temurtas/EE313-Project/README.md

# EE313-Project
Frequency Modulated Continuous Wave (FMCW) Based Distance Measuring System

Our EE313/Analog Electronics Laboratory Course Term Project about FMCW Radar Systems

------------
Halil Temurtaş
Erdem Tuna

METU / Ankara / Turkey
