temurtas/EE313-Project/Adsız.png

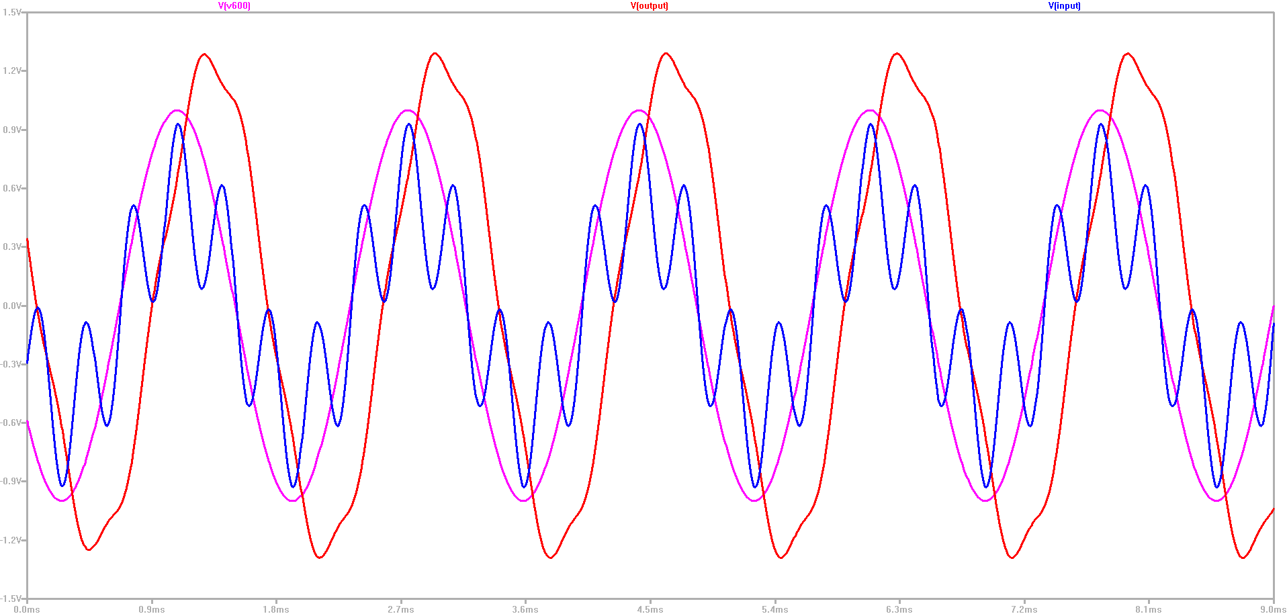
Adsız.png
