temurtas/EE313-Project/agc.png

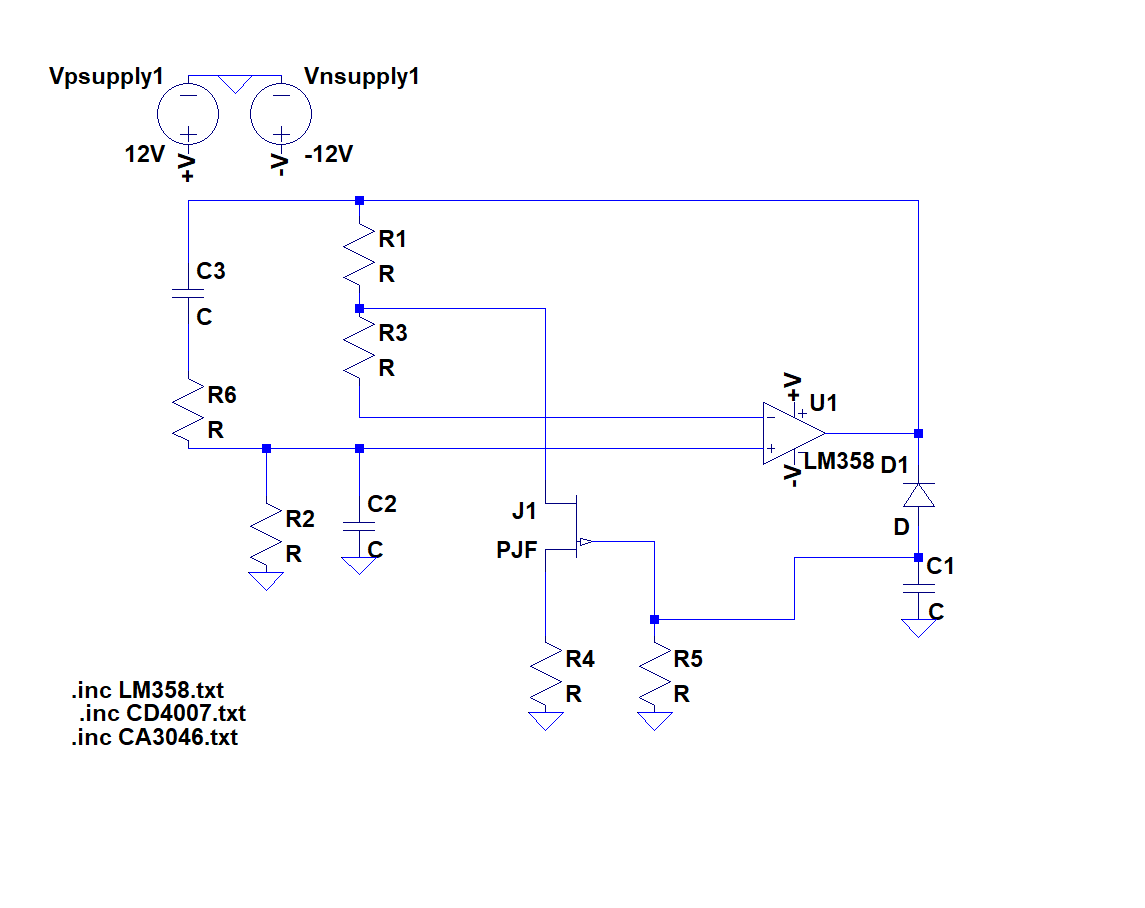
agc.png
