temurtas/EE313-Project/diagram2.png

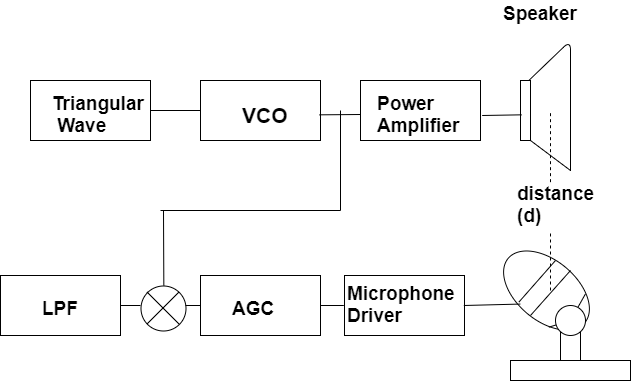
diagram2.png
