temurtas/EE313-Project/diagram3.png

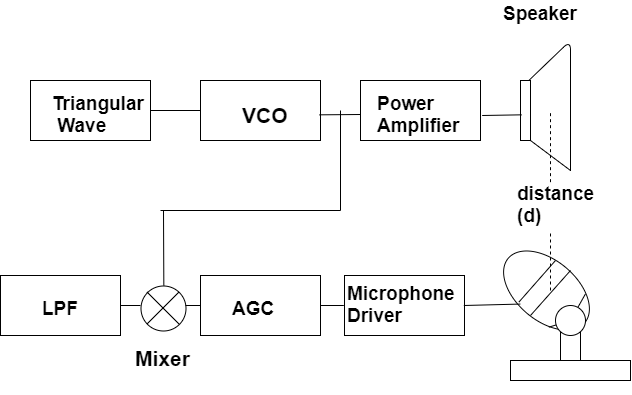
diagram3.png
