temurtas/EE313-Project/diagram.png

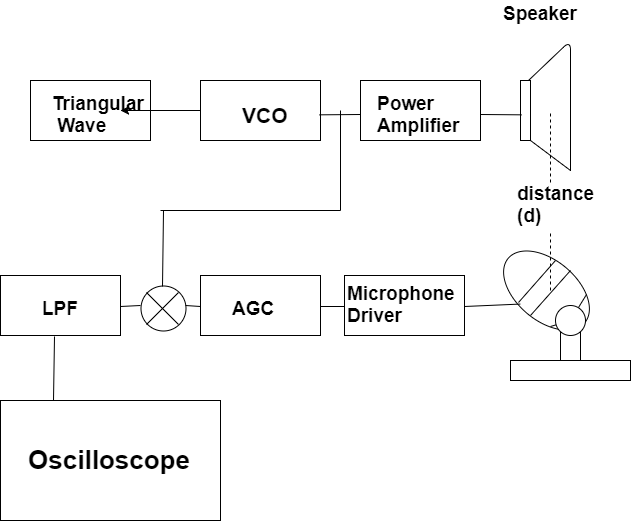
diagram.png
