temurtas/EE313-Project/electret.png

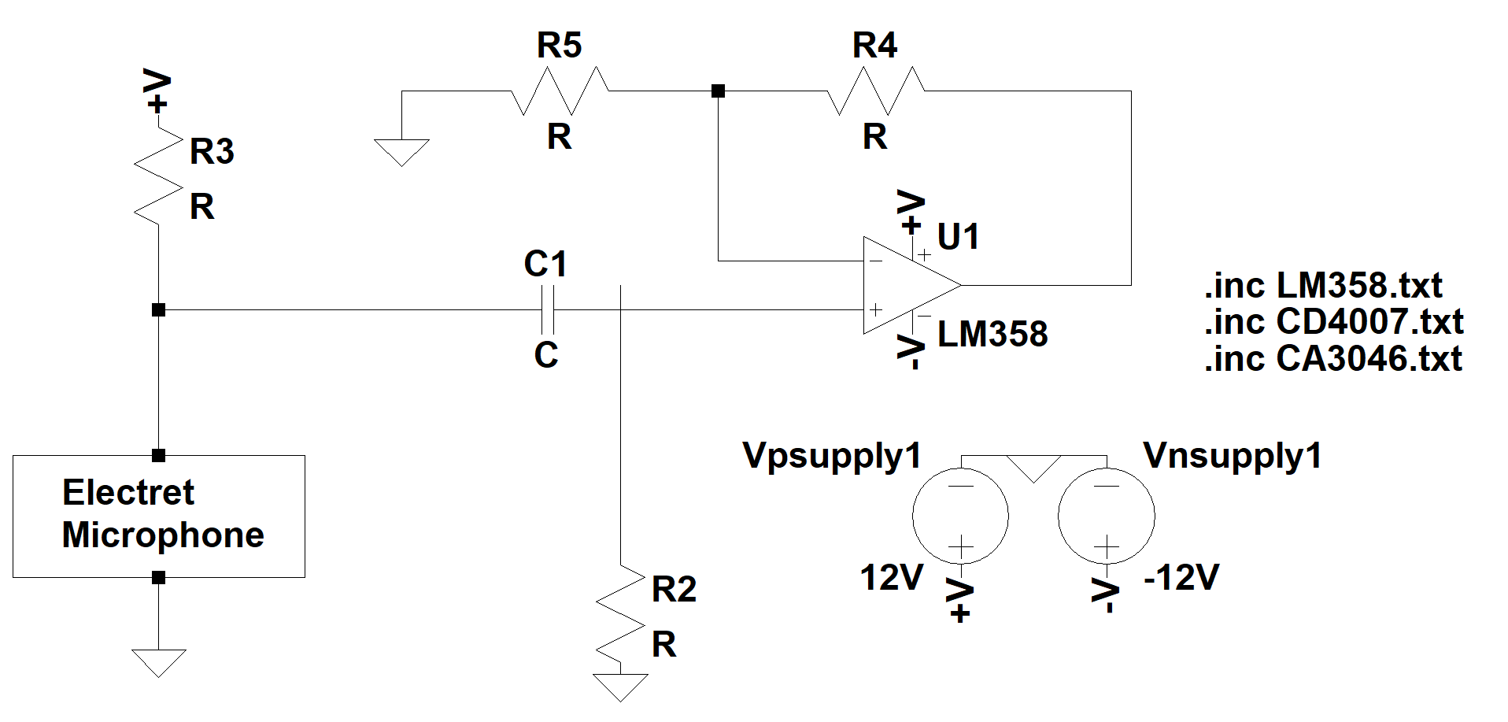
electret.png
