temurtas/EE313-Project/lpf_op1.png

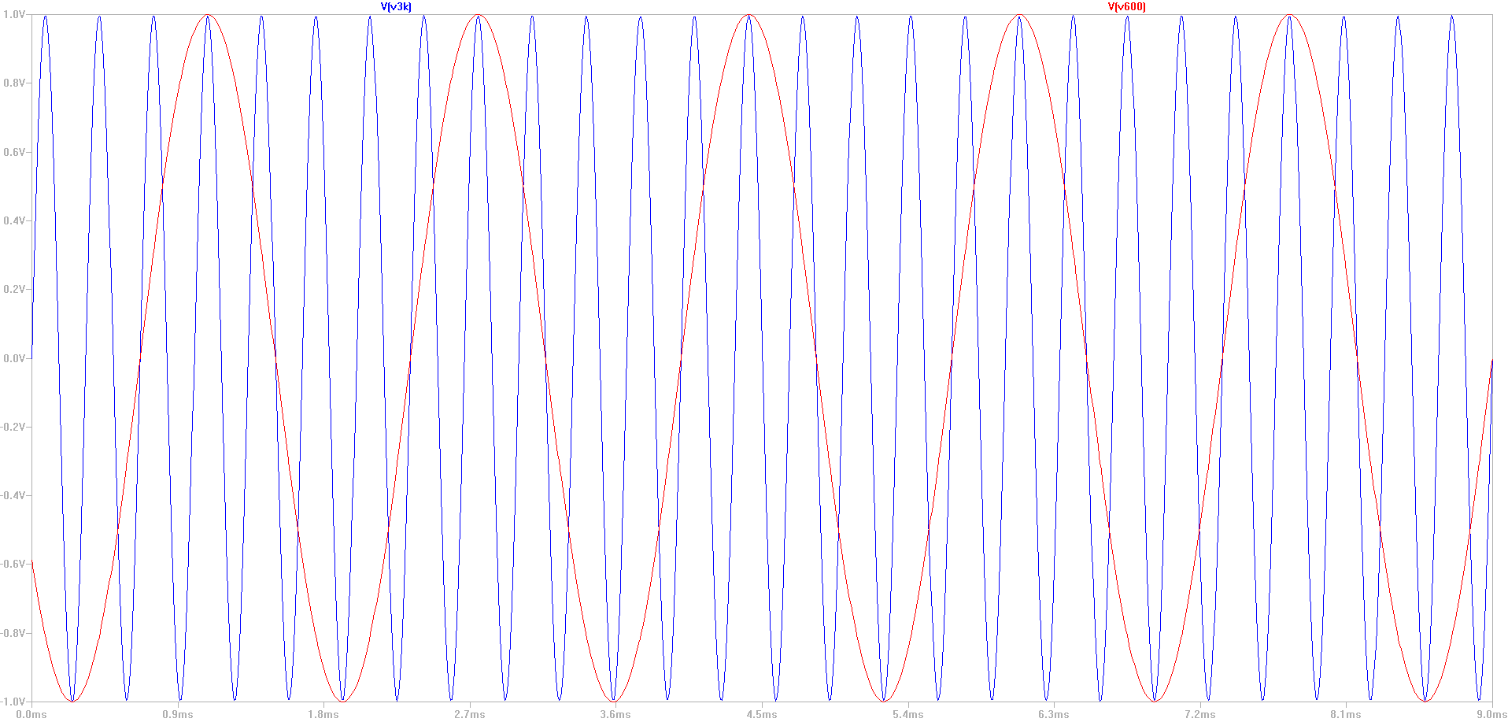
lpf_op1.png
