temurtas/EE313-Project/lpf_op2.png

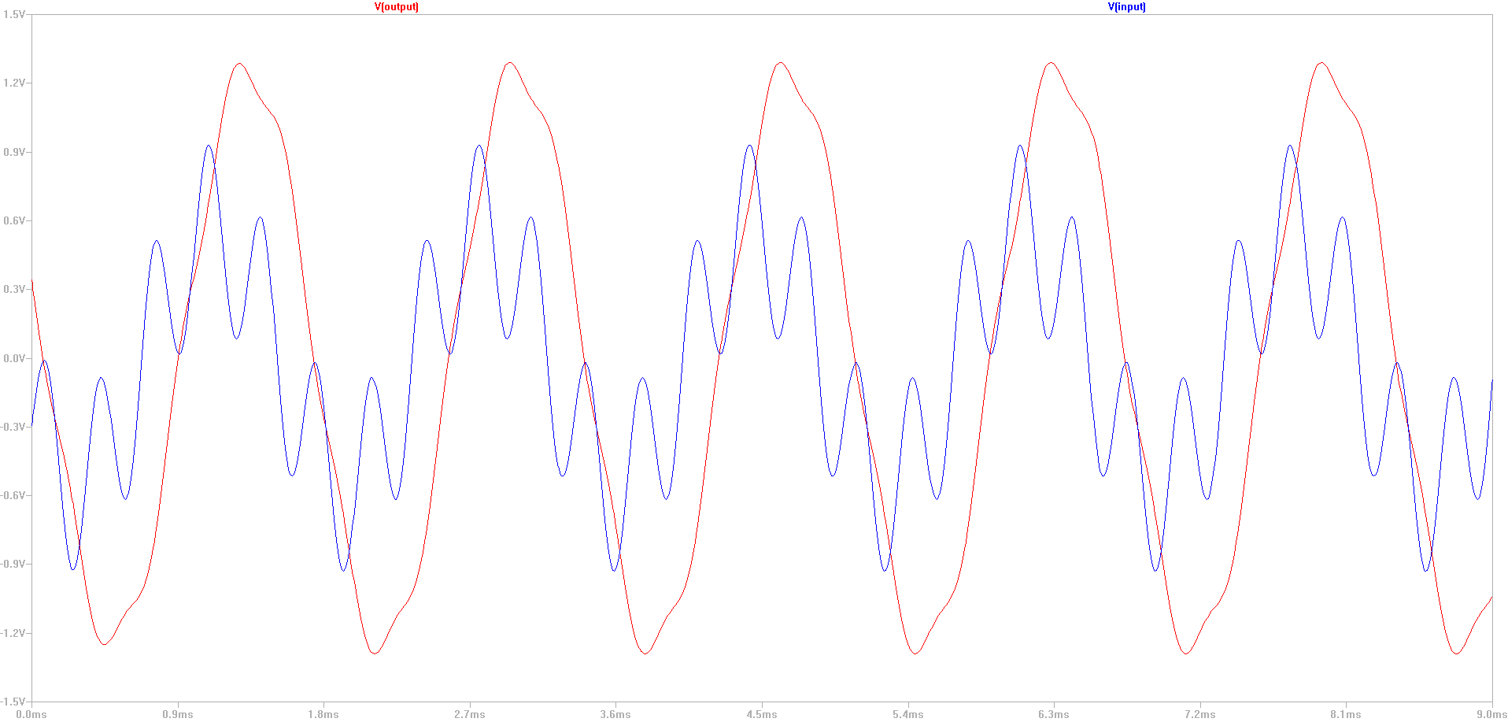
lpf_op2.png
