temurtas/EE313-Project/lpf_osc1.png

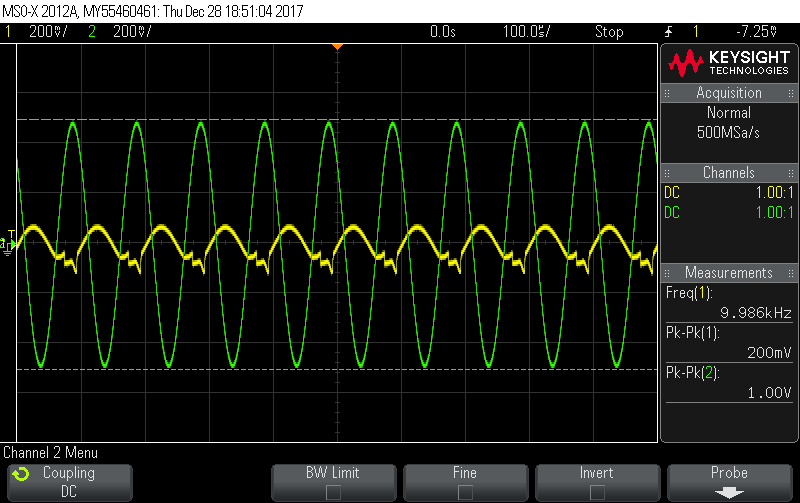
lpf_osc1.png
