temurtas/EE313-Project/lpf_osc3.png

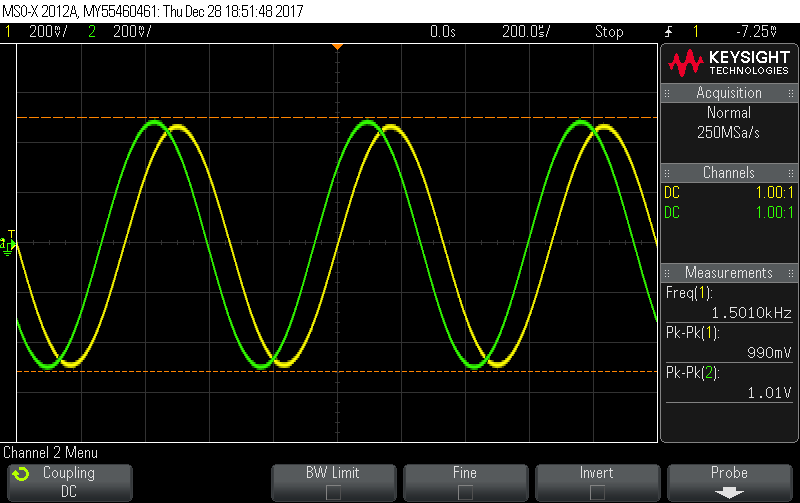
lpf_osc3.png
