temurtas/EE313-Project/lpf_v1.5.png

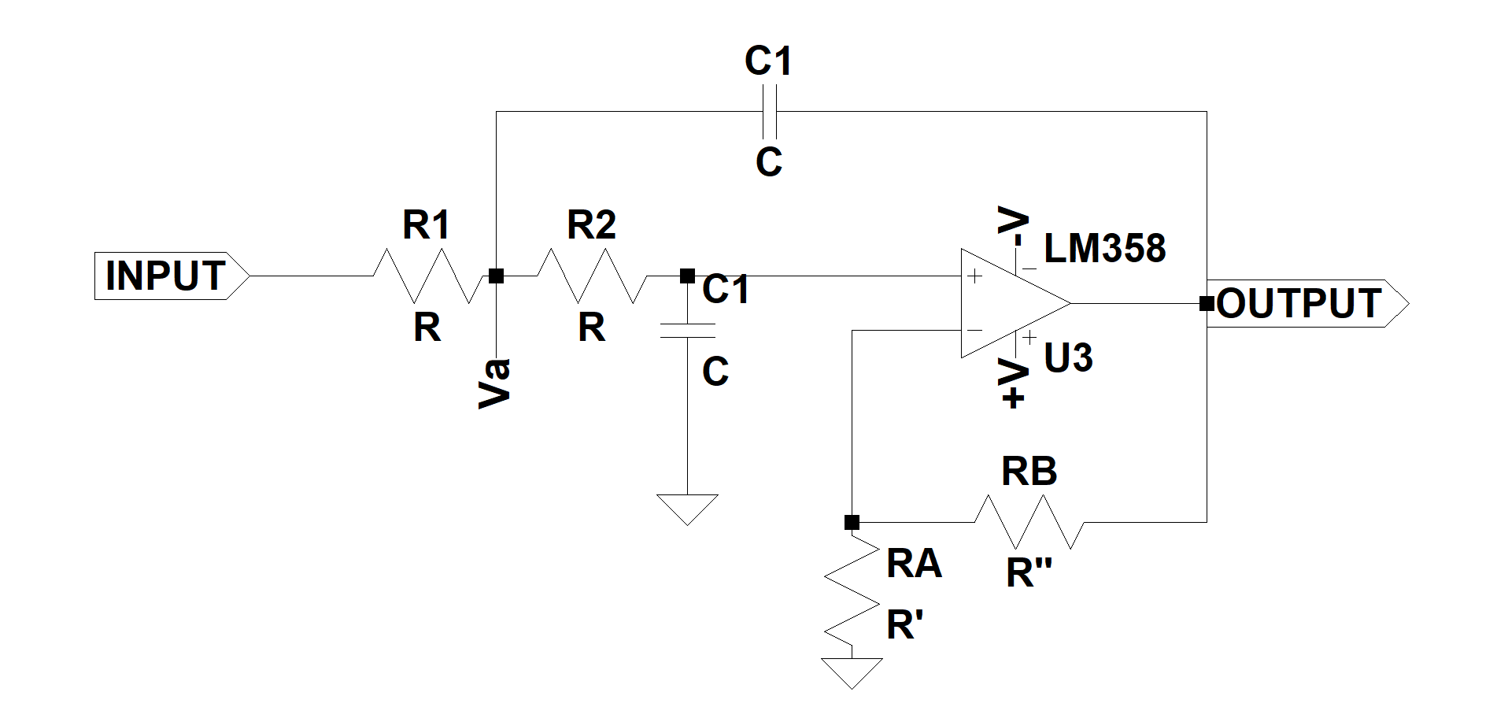
lpf_v1.5.png
