temurtas/EE313-Project/lpf_v1.png

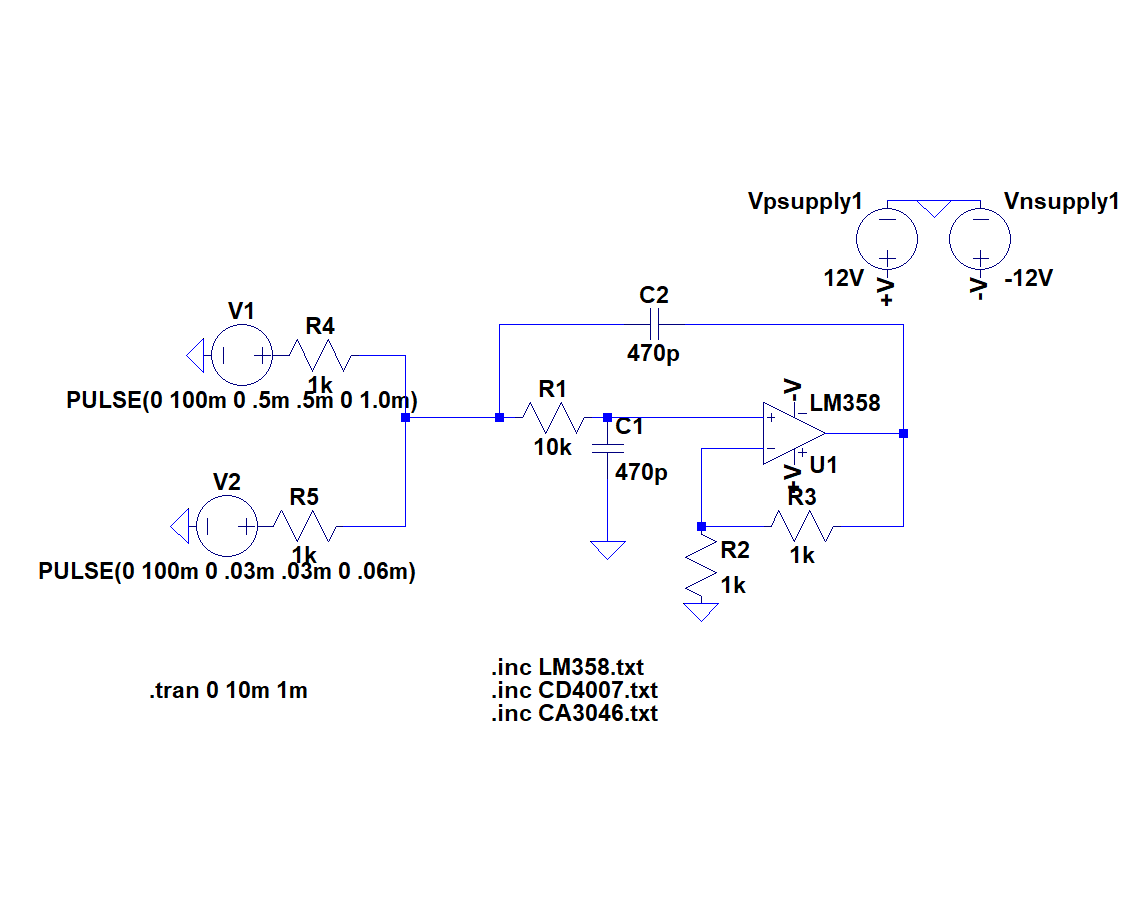
lpf_v1.png
