temurtas/EE313-Project/lpf_v3.png

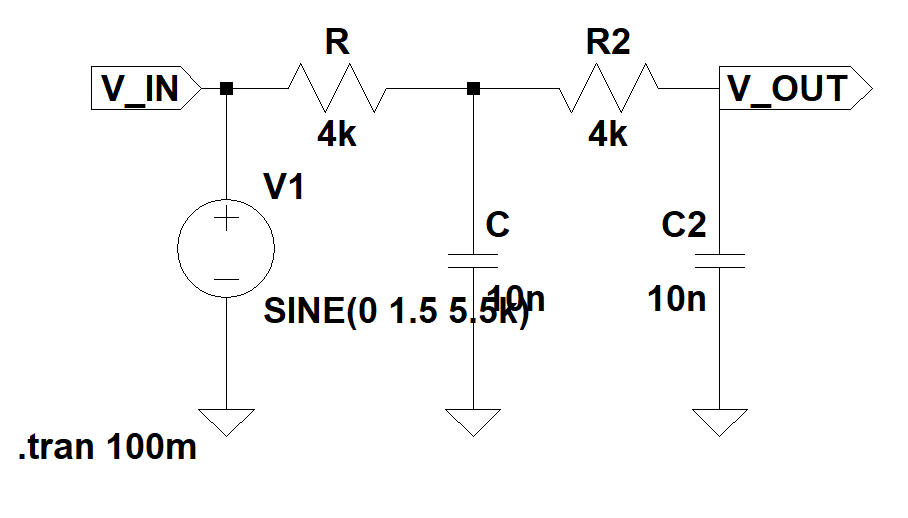
lpf_v3.png
