temurtas/EE313-Project/mic_v1.png

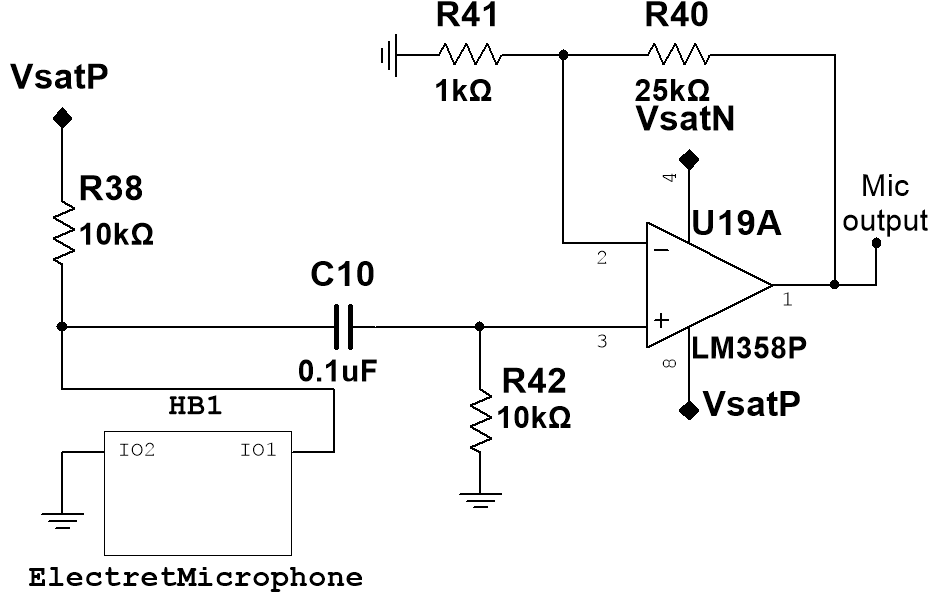
mic_v1.png
