temurtas/EE313-Project/mixer_fft2.png

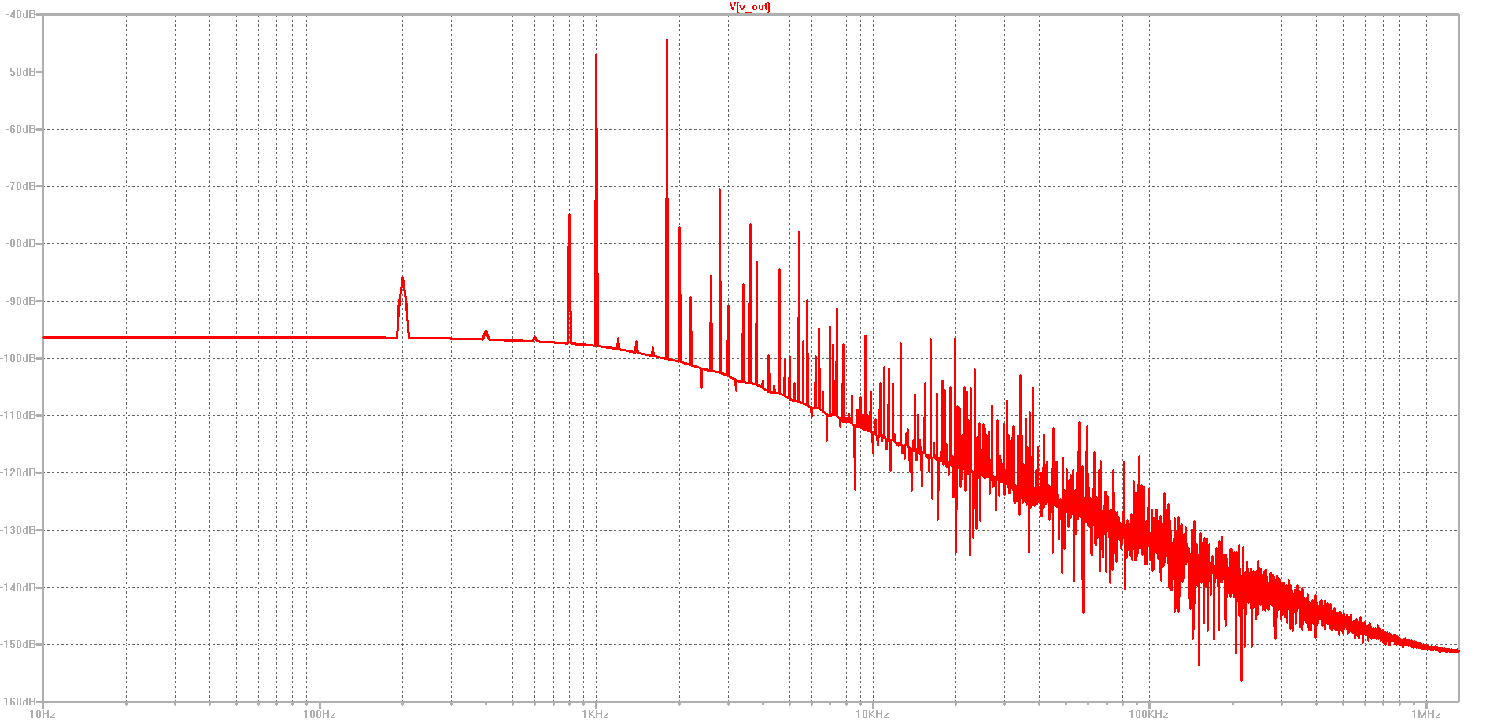
mixer_fft2.png
