temurtas/EE313-Project/mixer_fft.png

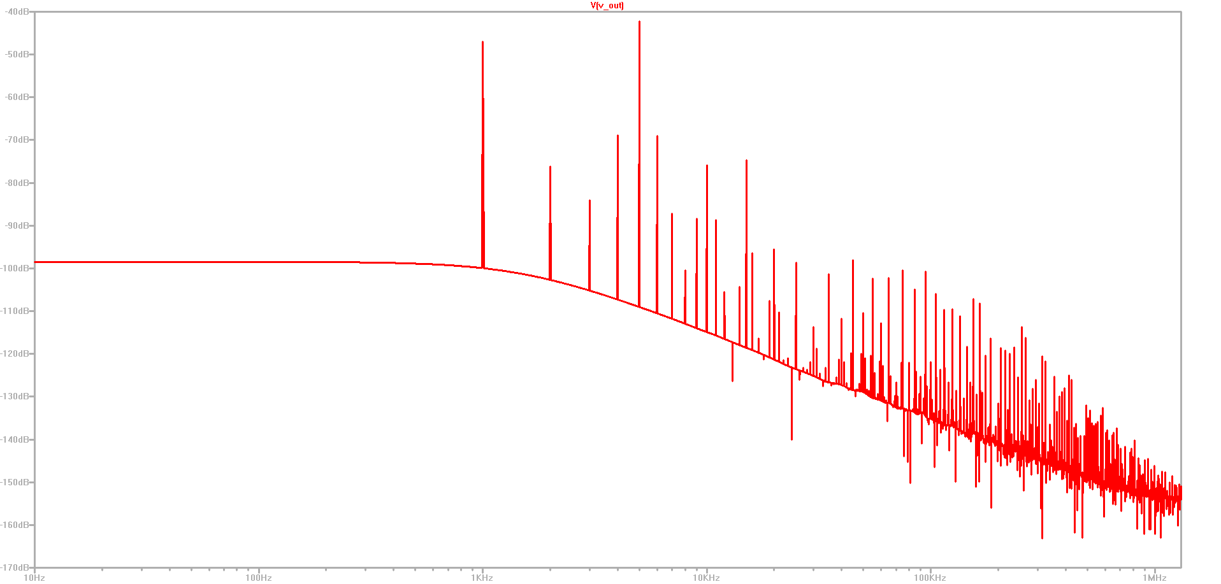
mixer_fft.png
