temurtas/EE313-Project/mixer_op1.png

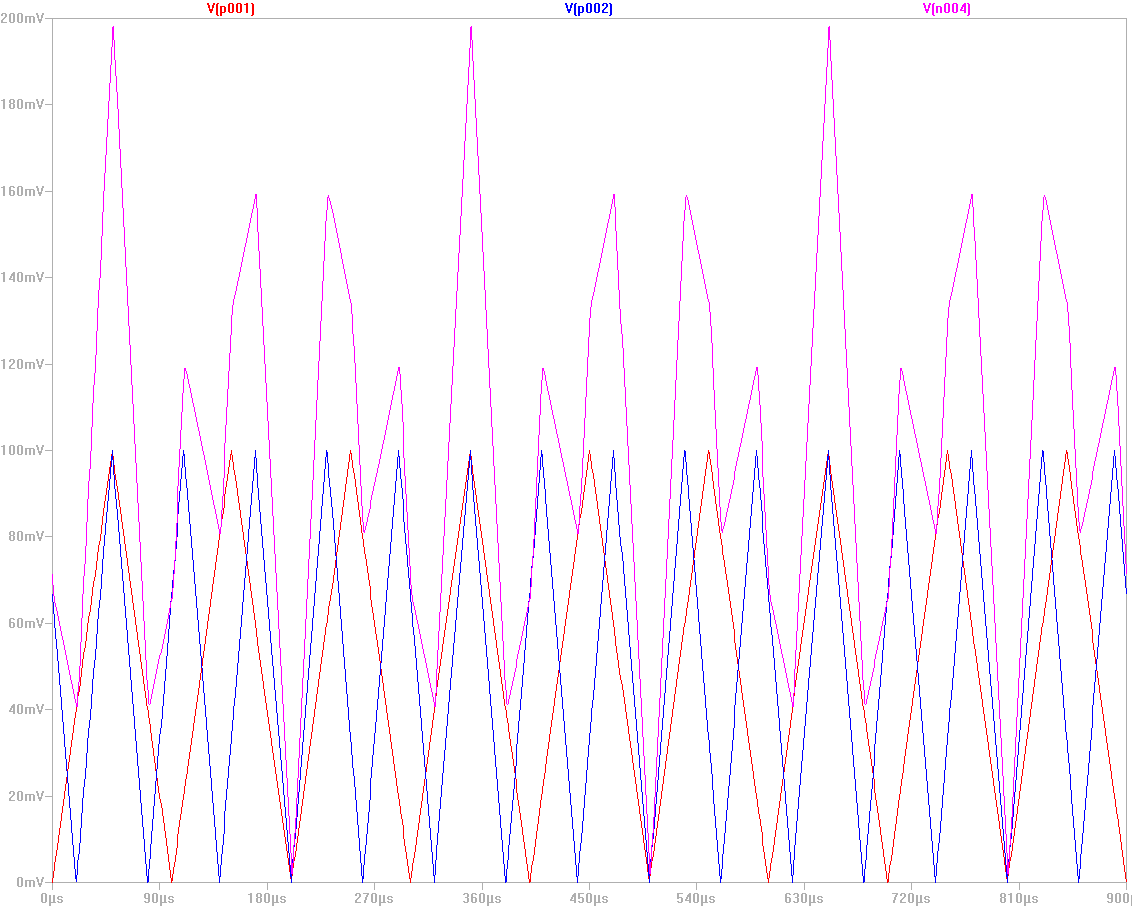
mixer_op1.png
