temurtas/EE313-Project/mixer_op1_5.png

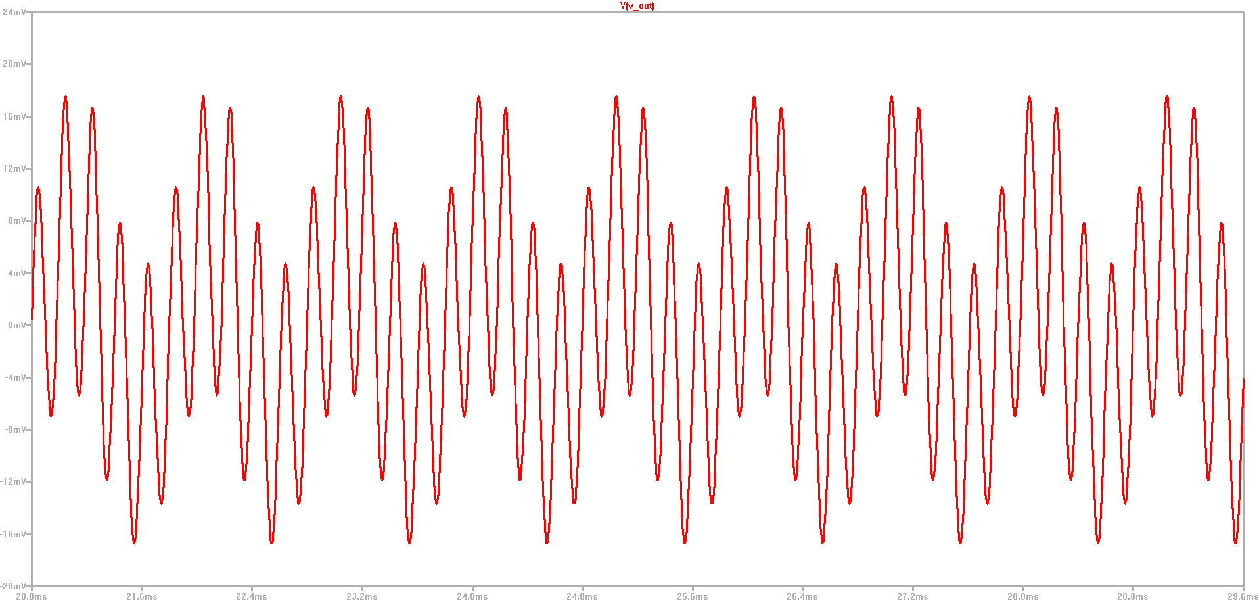
mixer_op1_5.png
