temurtas/EE313-Project/mixer_op2.png

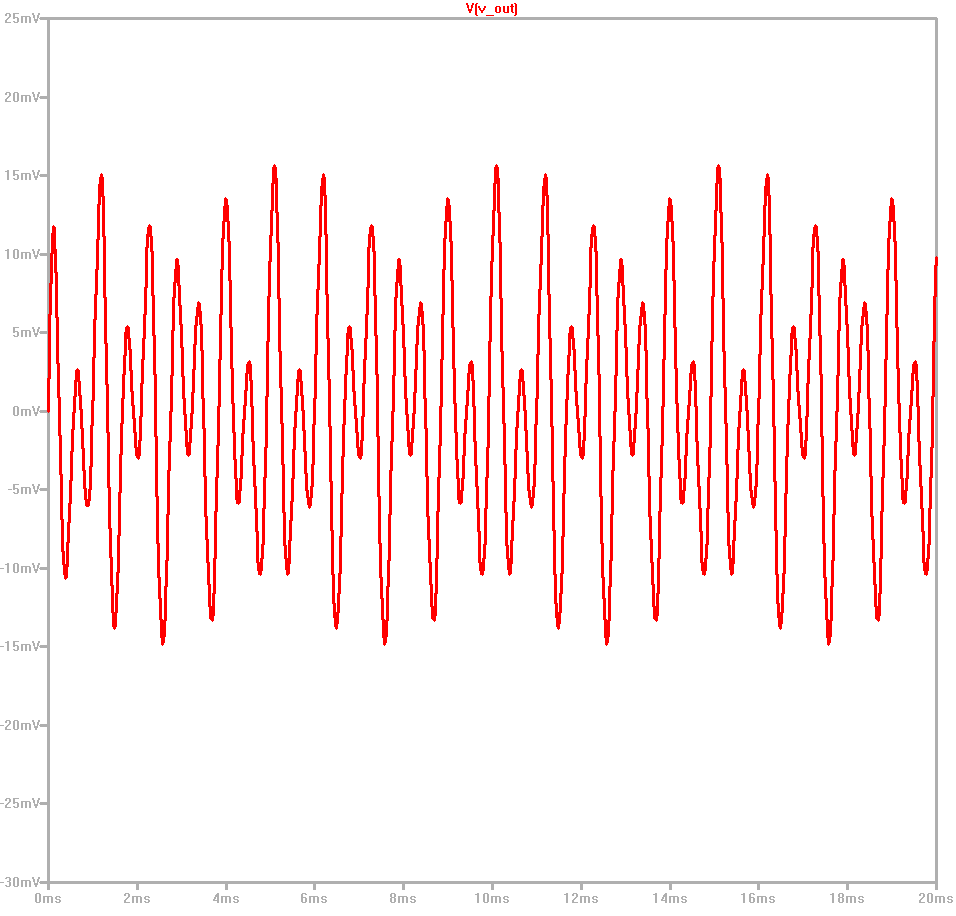
mixer_op2.png
