temurtas/EE313-Project/mixer_op4.png

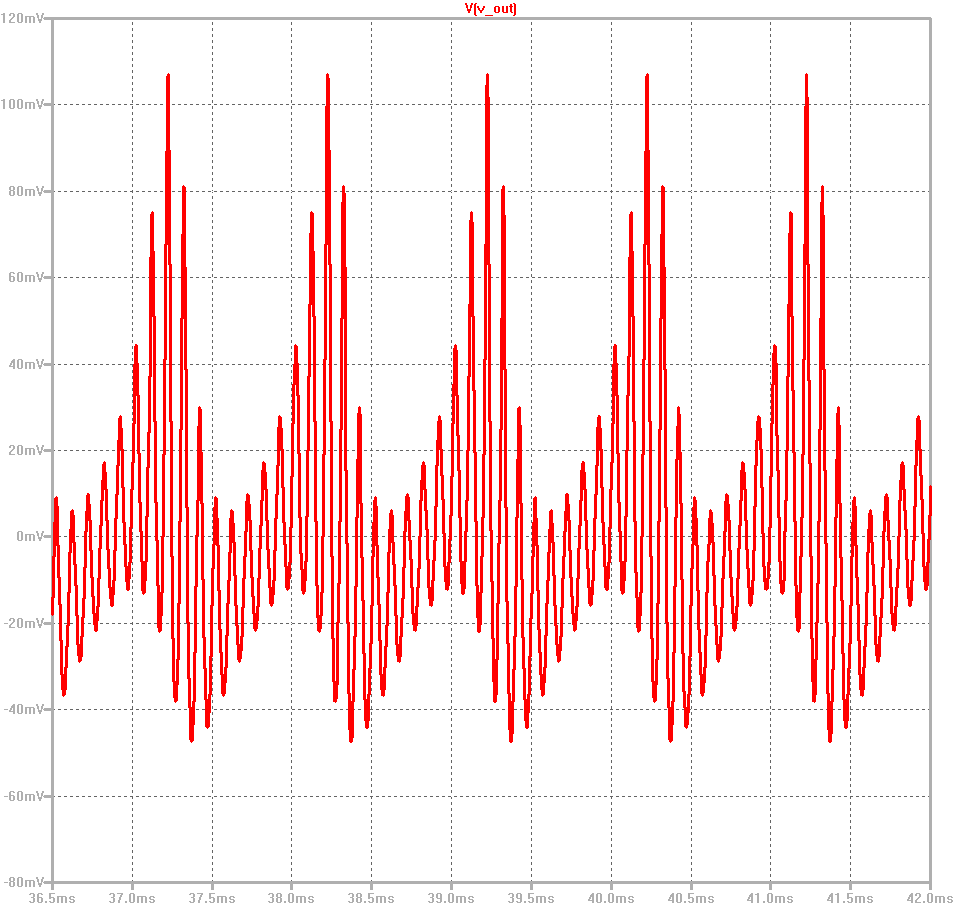
mixer_op4.png
