temurtas/EE313-Project/mixer_osc2.png

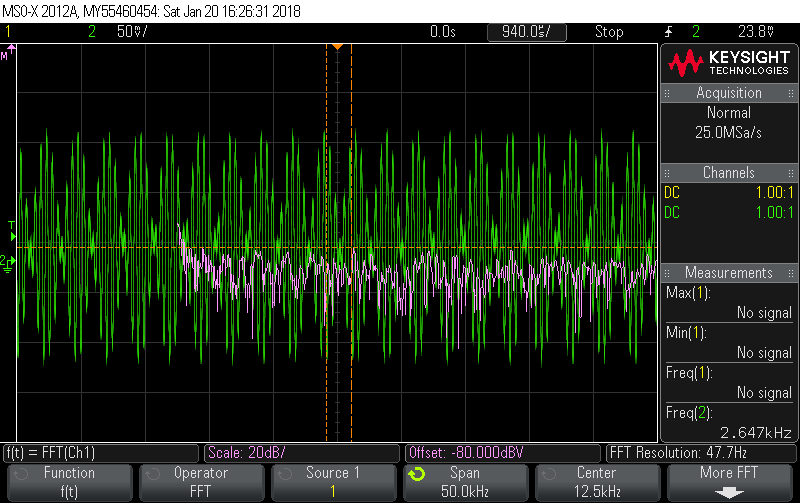
mixer_osc2.png
