temurtas/EE313-Project/mixer_v1_0.png

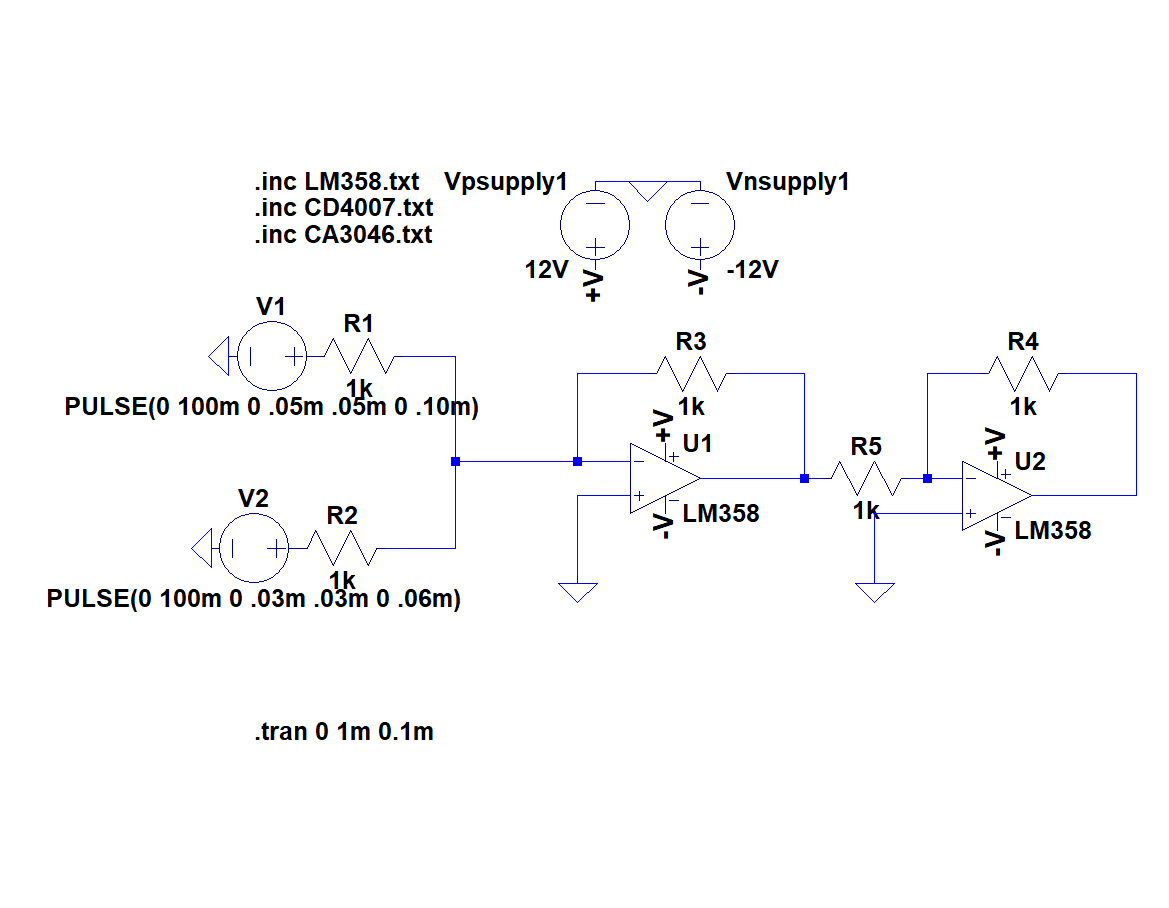
mixer_v1_0.png
