temurtas/EE313-Project/mixer_v1_5.png

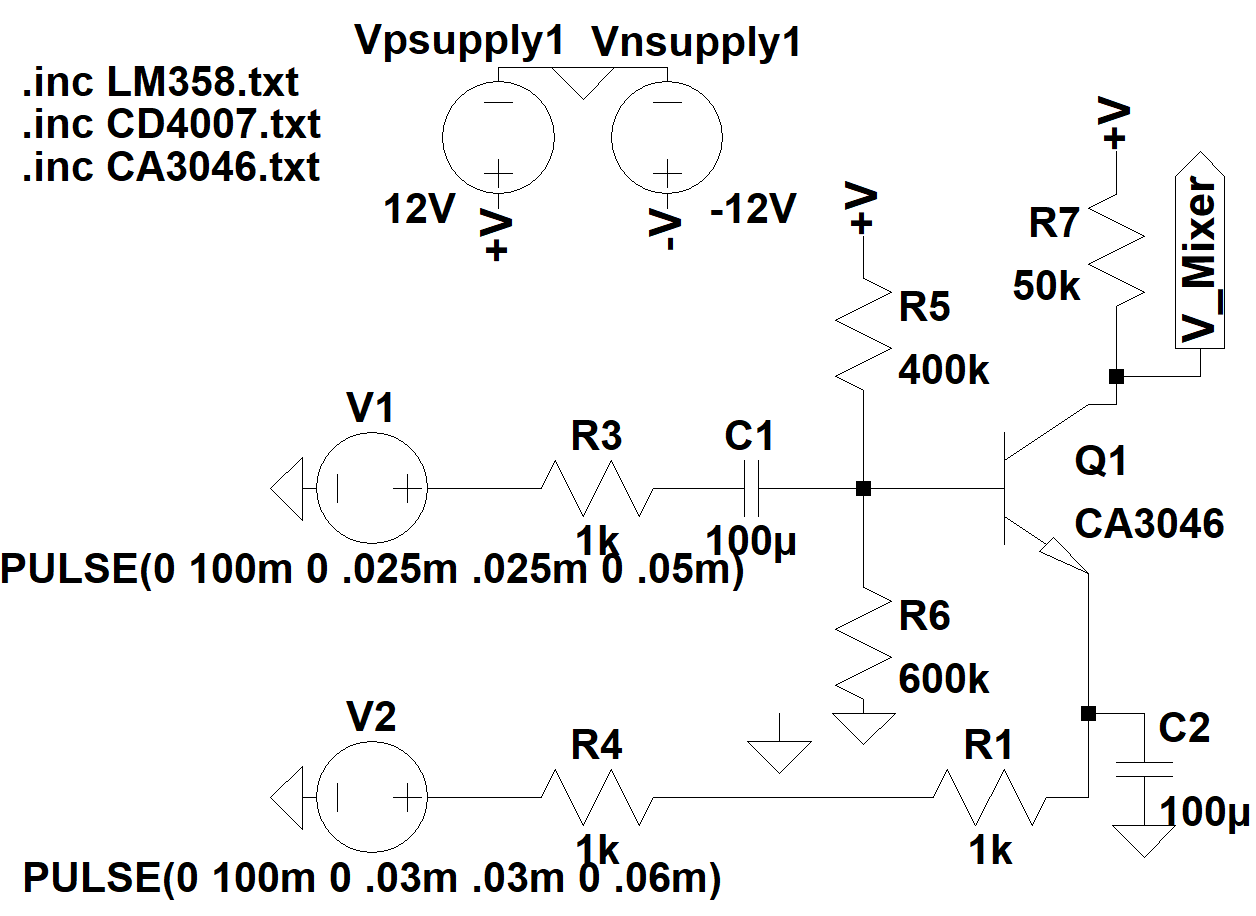
mixer_v1_5.png
