temurtas/EE313-Project/mixer_v2_0.png

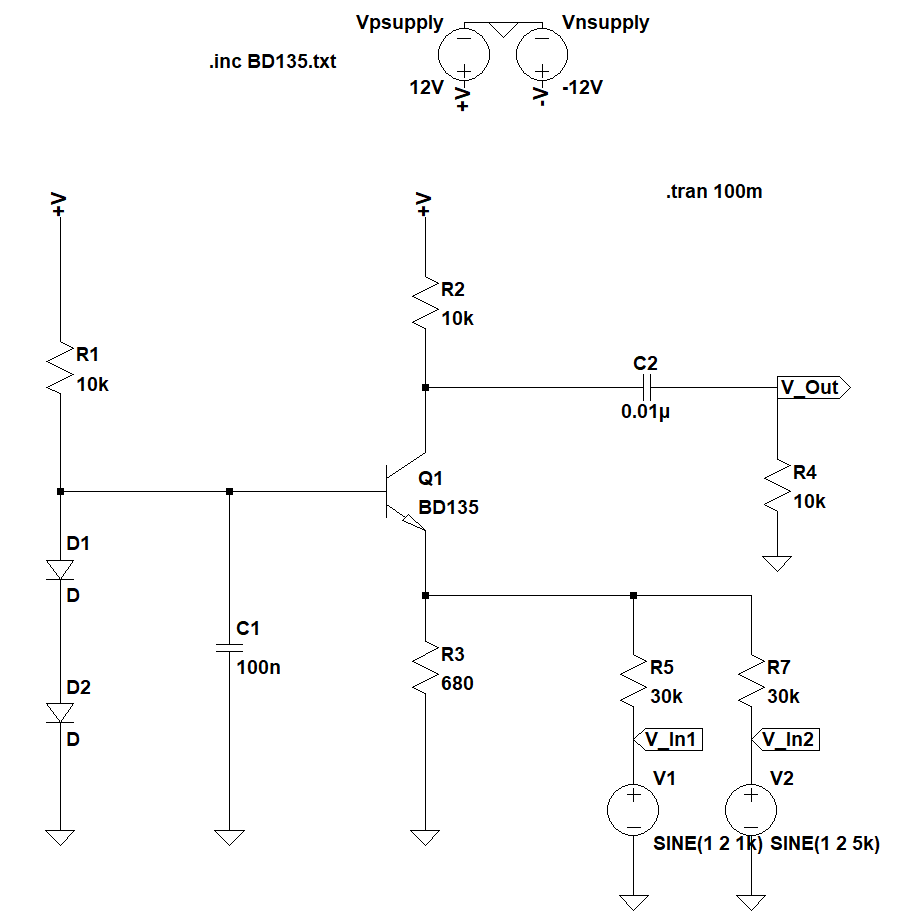
mixer_v2_0.png
