temurtas/EE313-Project/mixer_v2_1.png

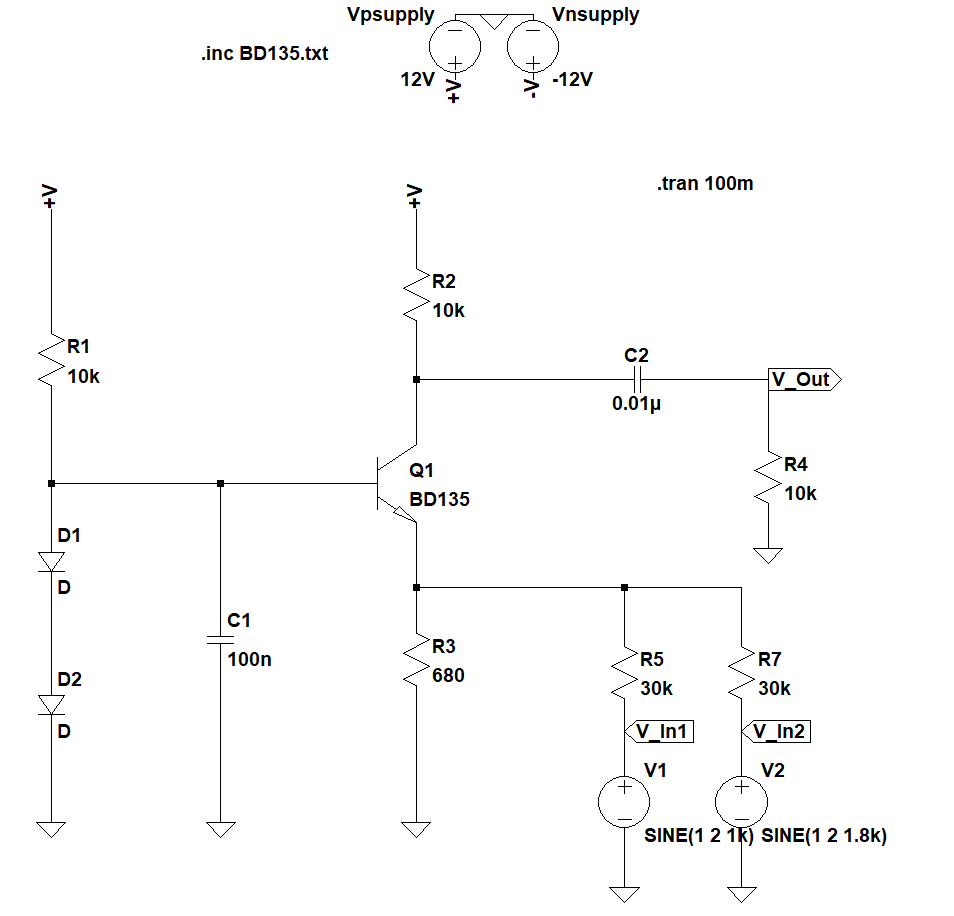
mixer_v2_1.png
