temurtas/EE313-Project/overall_op2.png

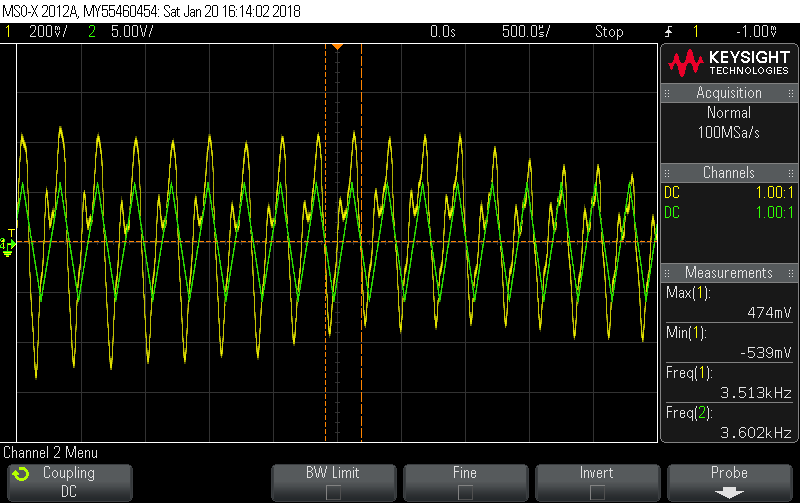
overall_op2.png
