temurtas/EE313-Project/overall_op.png

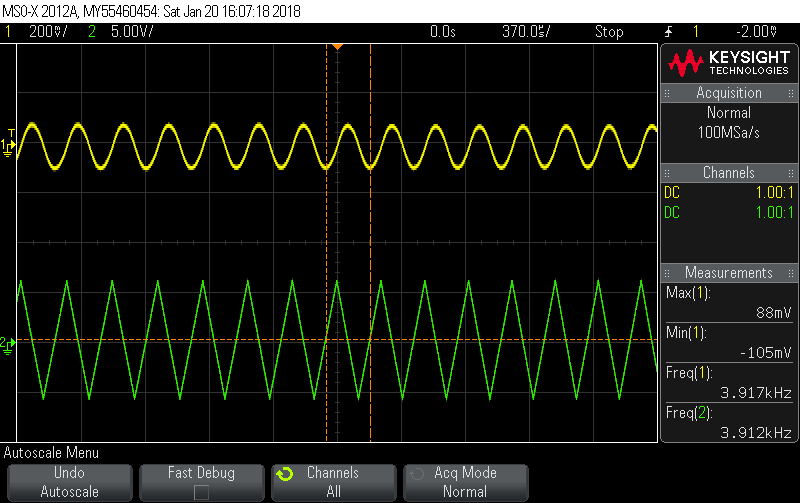
overall_op.png
