temurtas/EE313-Project/PowerAmp_Circuit.PNG

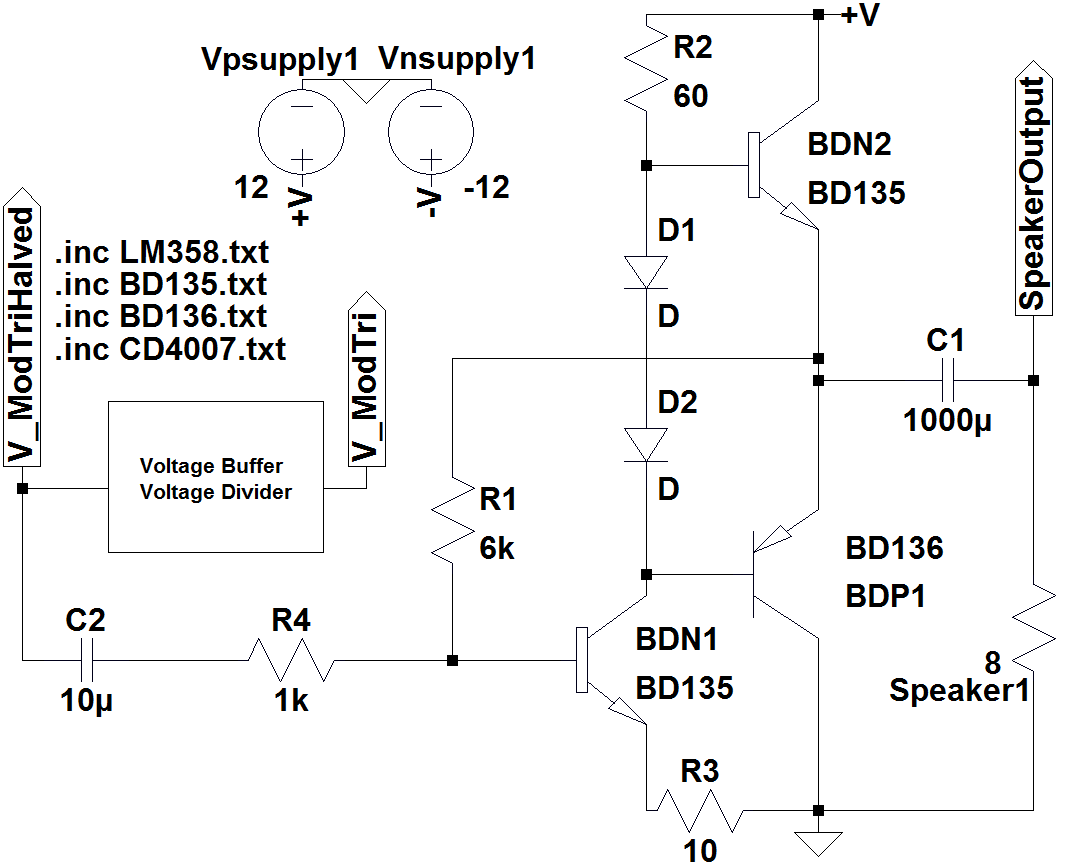
PowerAmp_Circuit.PNG
