temurtas/EE313-Project/scope_13.png

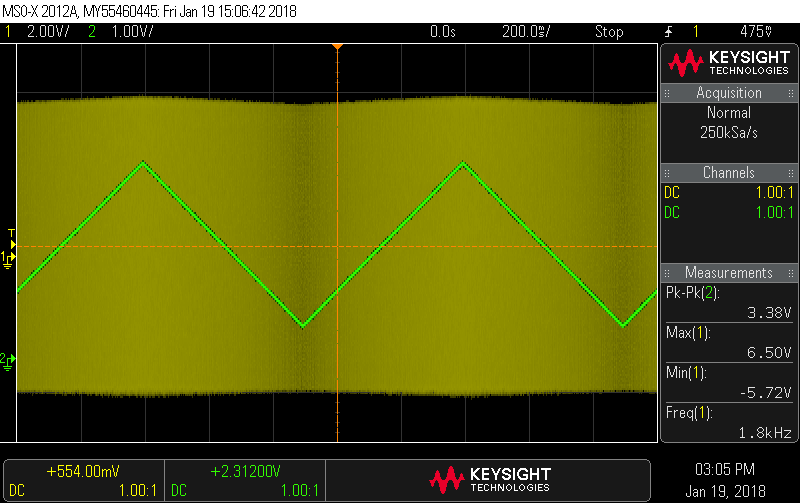
scope_13.png
