temurtas/EE313-Project/scope_14.png

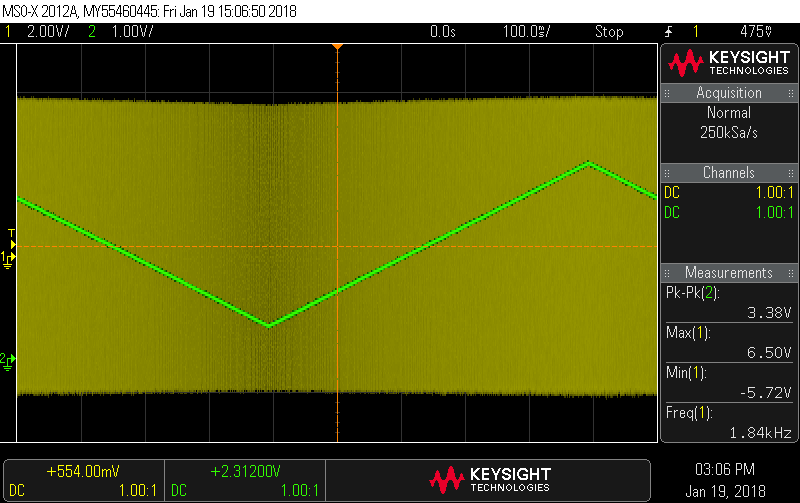
scope_14.png
