temurtas/EE313-Project/scope_15.png

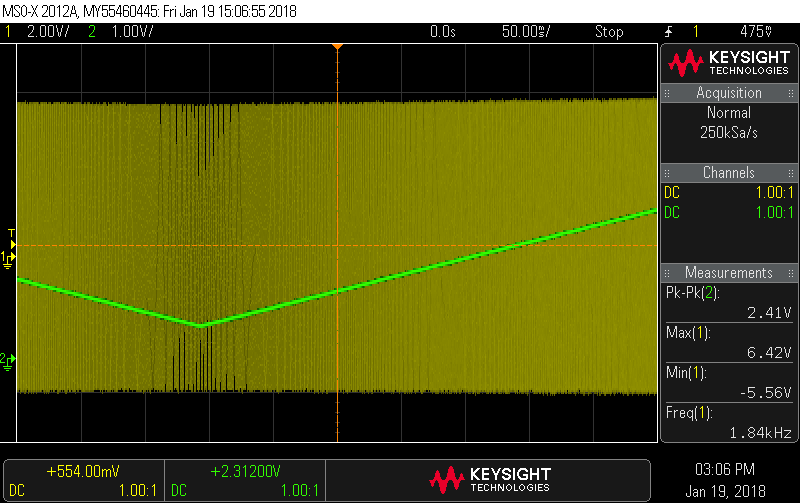
scope_15.png
