temurtas/EE313-Project/scope_16.png

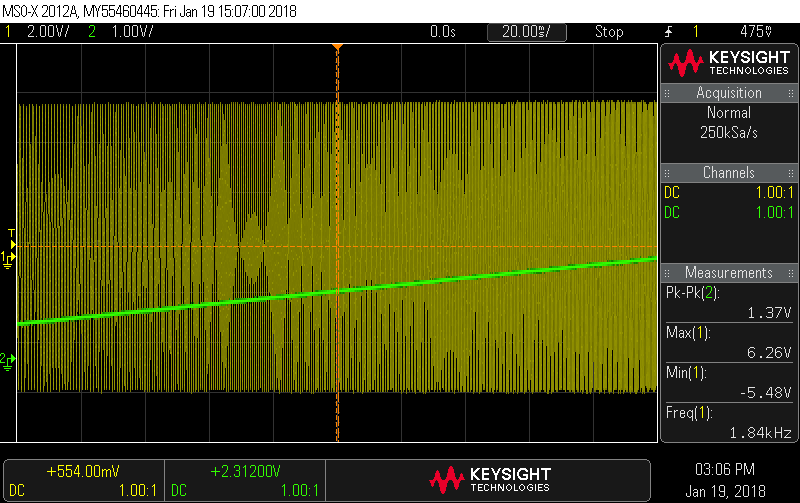
scope_16.png
