temurtas/EE313-Project/scope_17.png

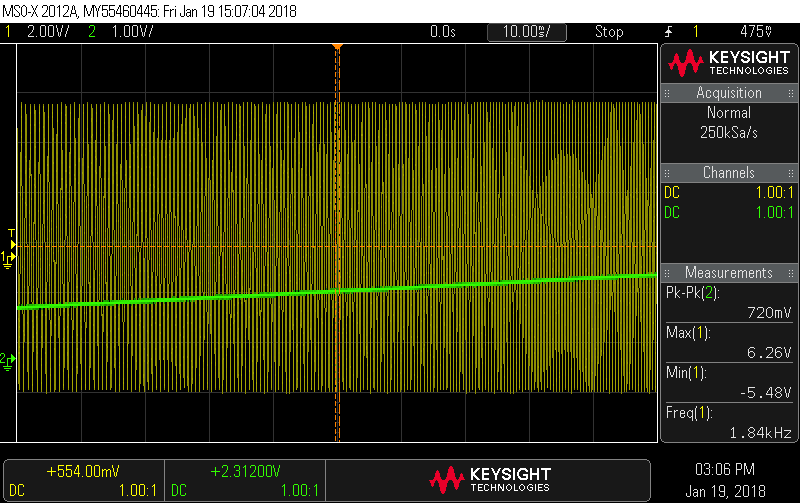
scope_17.png
