temurtas/EE313-Project/scope_18.png

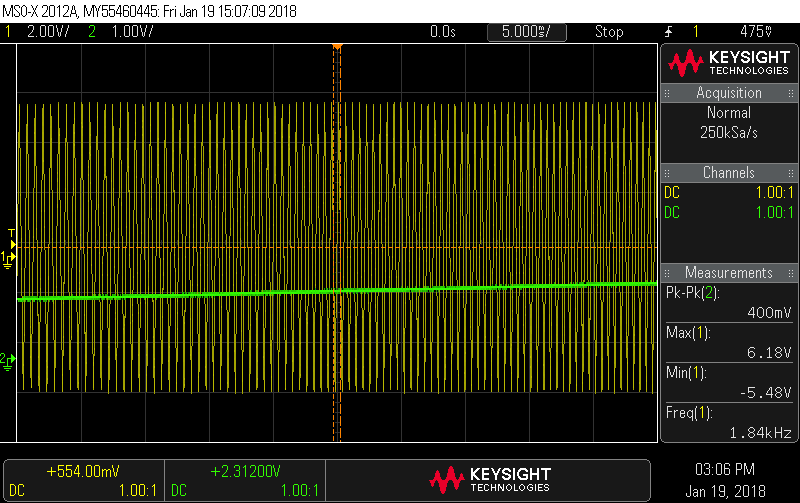
scope_18.png
