temurtas/EE313-Project/scope_19.png

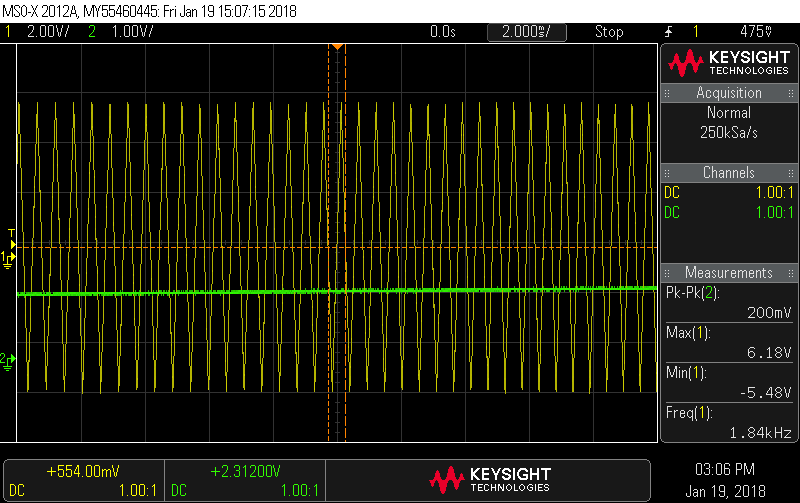
scope_19.png
