temurtas/EE313-Project/scope_20.png

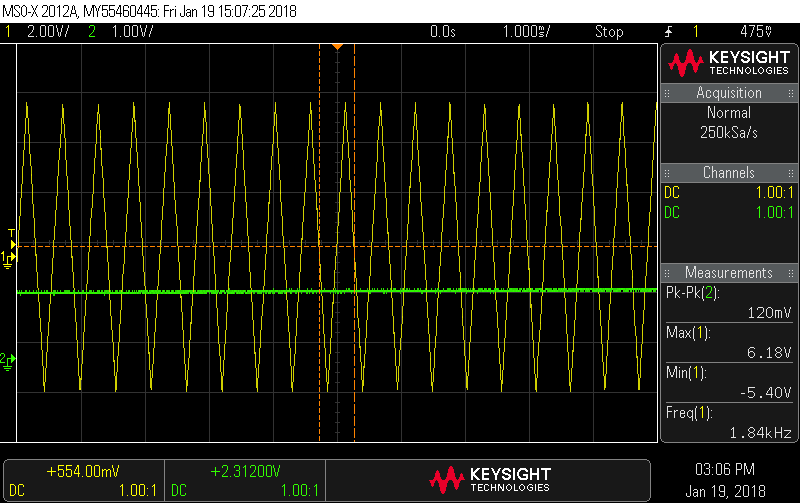
scope_20.png
