temurtas/EE313-Project/scope_21.png

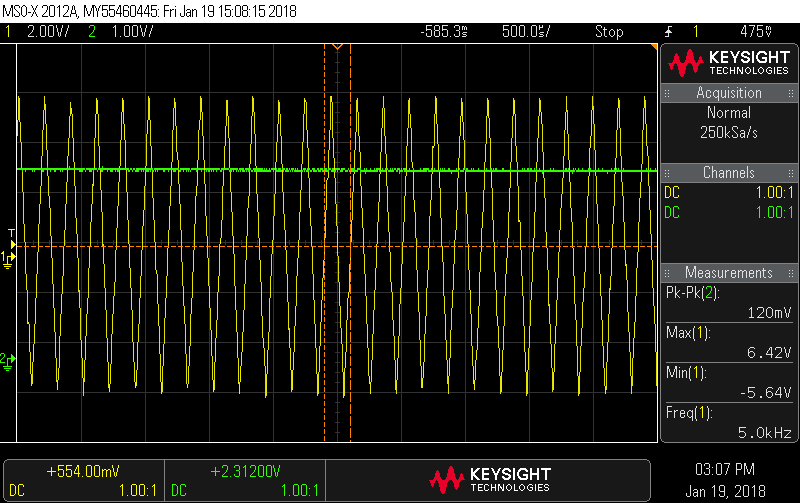
scope_21.png
