temurtas/EE313-Project/scope_22.png

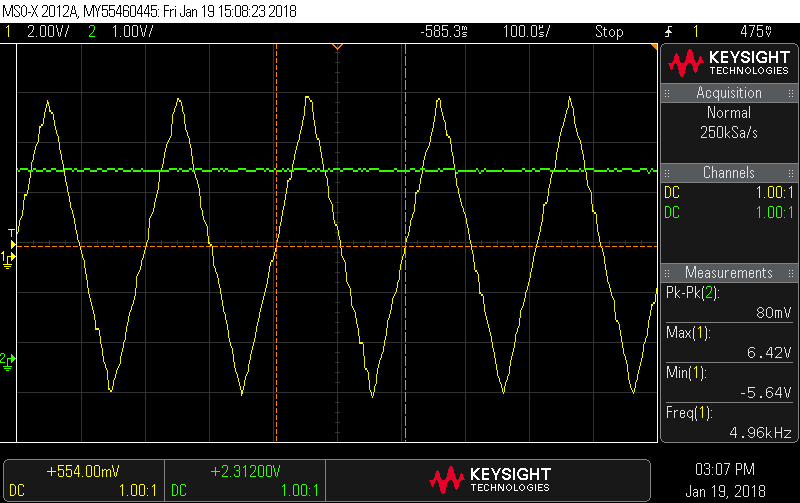
scope_22.png
