temurtas/EE313-Project/scope_23.png

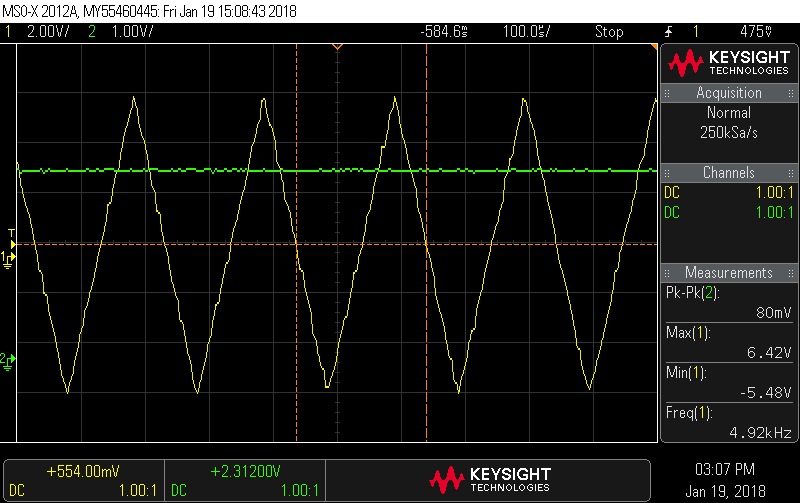
scope_23.png
