temurtas/EE313-Project/scope_25.png

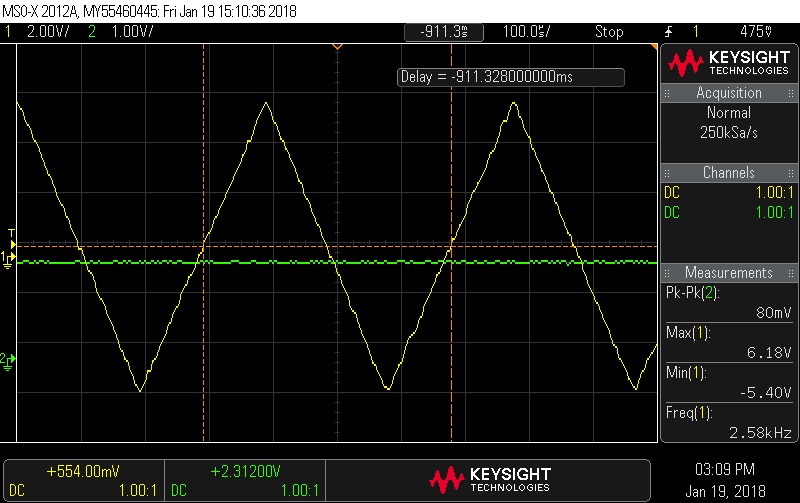
scope_25.png
