temurtas/EE313-Project/scope_26.png

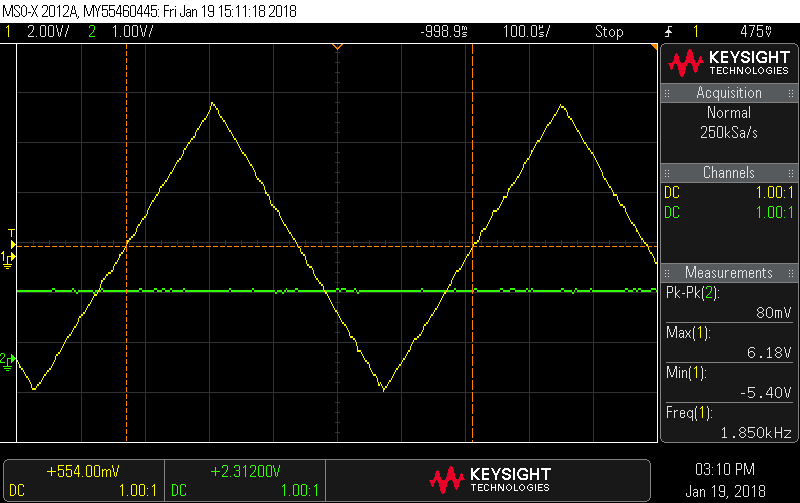
scope_26.png
