temurtas/EE313-Project/scope_27.png

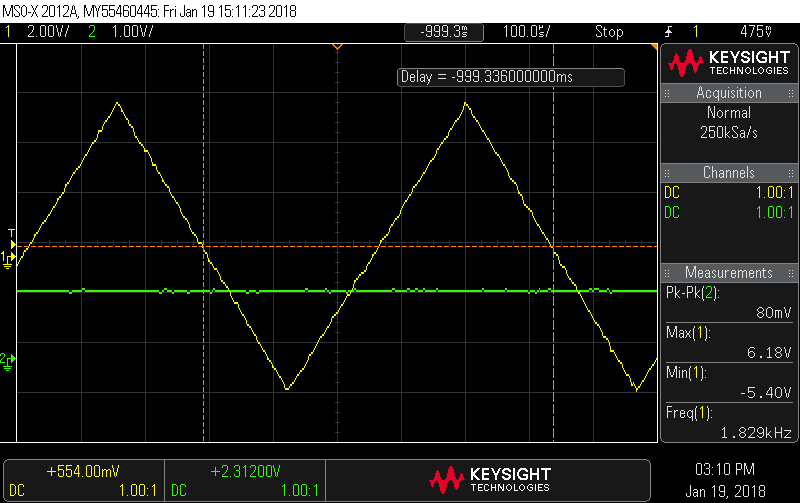
scope_27.png
