temurtas/EE313-Project/scope_29.png

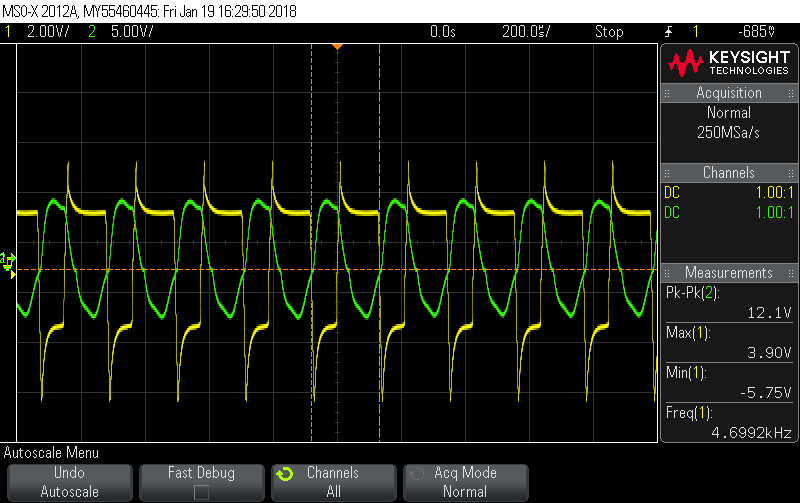
scope_29.png
