temurtas/EE313-Project/scope_31.png

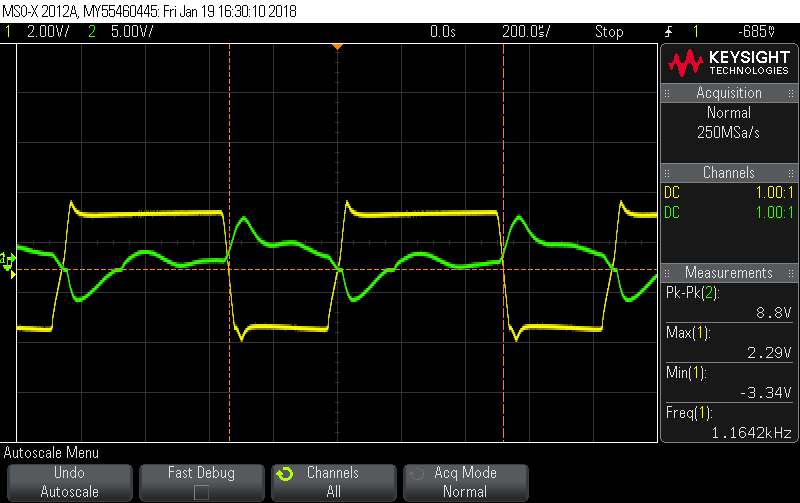
scope_31.png
