temurtas/EE313-Project/scope_32.png

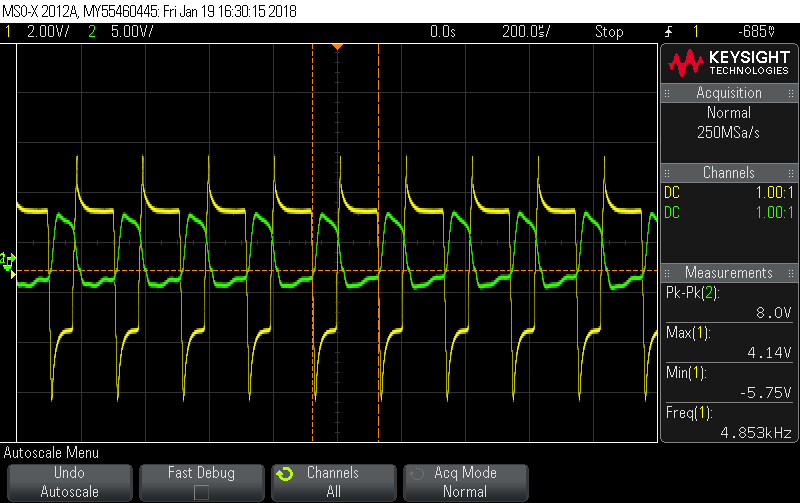
scope_32.png
