temurtas/EE313-Project/scope_35.png

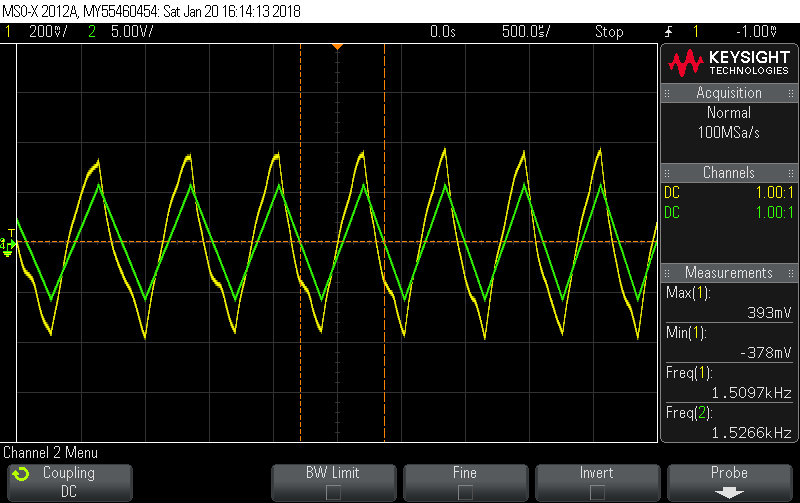
scope_35.png
