temurtas/EE313-Project/scope_36.png

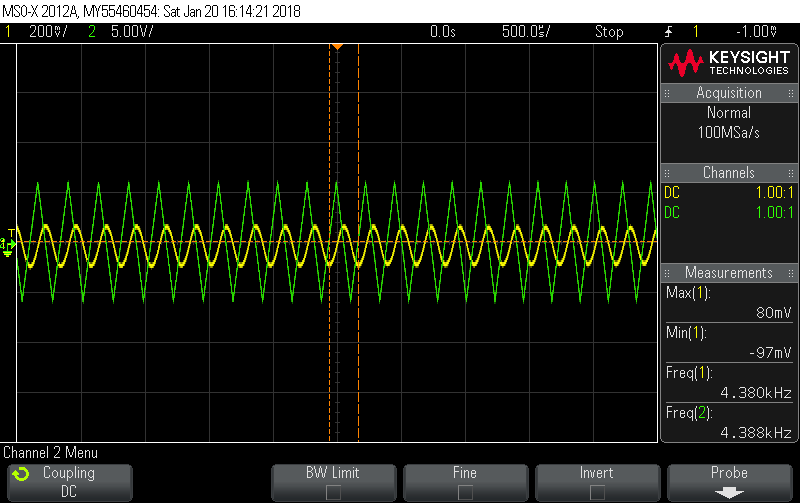
scope_36.png
