temurtas/EE313-Project/Speaker.png

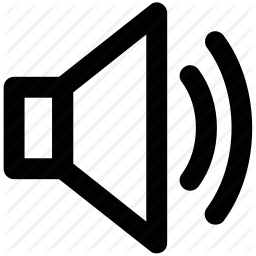
Speaker.png
