temurtas/EE313-Project/VCO_Circuit.PNG

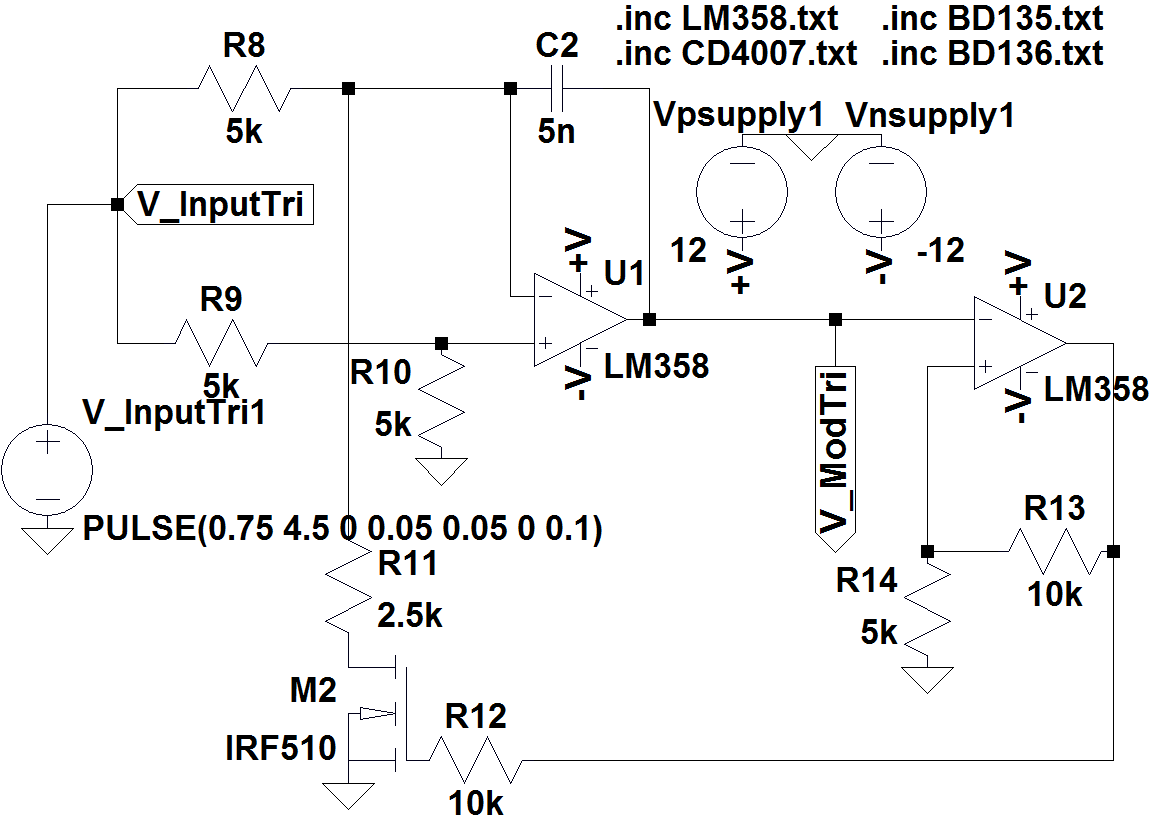
VCO_Circuit.PNG
