temurtas/EE313-Project/vco_osc1.png

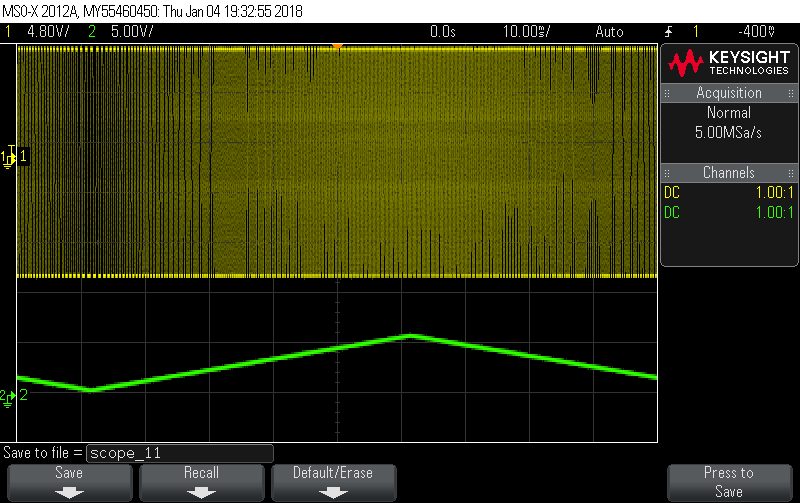
vco_osc1.png
