temurtas/EE313-Project/vco_osc2.png

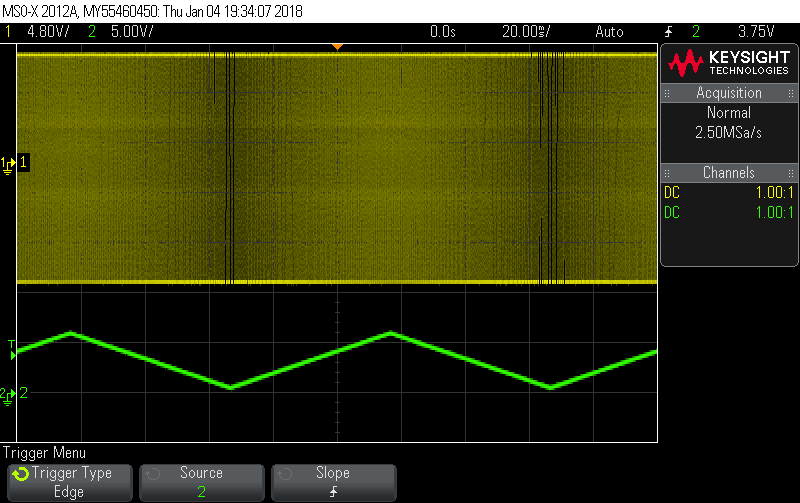
vco_osc2.png
