temurtas/EE313-Project/LTSpice/VCO_only.asc

C1: cap; 180p
M1: nmos; 2N7002
R1: res; 100k
R2: res; 51k
R3: res; 51k
R4: res; 51k
R5: res; 100K
R6: res; 100k
U1: opamp2; LF353
U2: opamp2; LF353
V_InputTri1: voltage; PULSE(0.75 4.5 0 0.05 0.05 0 0.1)
Vnsupply1: voltage; -12
Vpsupply1: voltage; 12
Named nets: 0, +V, -V, V_ModTri, V_InputTri
.inc LF353.txt
.tran 0 9.1 9 startup uic
