temurtas/EE313-Project/LTSpice/poweramp - original.asc

C1: cap; 10µ
C3: EuropeanPolcap; 1000µ
D1: diode
D2: diode
Q1: npn3
Q2: npn
Q3: pnp
R1: res; 10k
R2: res; 10
R3: res; 1k
R5: res; 100
R7: res; 1
R8: res; 1
Speaker: res; 8
V1: battery; 20
V2: signal; SINE(0 2.5 400)
Named nets: 0
.tran 0 5 1 1
