temurtas/EE313-Project/LTSpice/poweramp.asc

BD1: npn3
BD135: npn3
C1: EuropeanPolcap; 1000µ
C3: cap; 10µ
D1: diode
D2: diode
Q1: pnp; BD136
R1: res; 6k
R2: res; 60
R5: res; 10
R6: res; 1k
Speaker1: res; 8
V1: voltage; PULSE(0 2 0 1u 1u .5m 1m)
V2: voltage; PULSE(-2.25 2.25 0 .5m .5m 0 1m)
V3: battery; 12
Vnsupply: voltage; -12
Vpsupply: voltage; 12
Named nets: 0, +V, -V, Vin, Vout
.inc LM358.txt
.inc CD4007.txt
.inc CA3046.txt
;tran 0 9.2 9.19 startup uic
.inc BD135.txt
.inc BD136.txt
.tran 0 9 8.99 uic
