temurtas/EE313-Project/LTSpice/VCO+PowerAmp.asc

BDN1: npn3; BD135
BDN2: npn3; BD135
BDP1: pnp; BD136
C1: cap; 5n
C2: cap; 1000µ
C4: cap; 10µ
D1: diode
D2: diode
M1: nmos; IRF510
R1: res; 5k
R2: res; 5k
R3: res; 5k
R4: res; 2.5k
R5: res; 5k
R6: res; 3k
R7: res; 10k
R8: res; 5k
R9: res; 6k
R10: res; 60
R11: res; 10
R17: res; 1k
Speaker1: res; 8
U1: opamp2; LM318
U2: opamp2; LM318
U3: opamp2; LM358
U4: opamp2; LM358
V3: voltage; PULSE(-2.25 2.25 0 .5m .5m 0 1m)
V_InputTri1: voltage; PULSE(0.75 4.5 0 0.05 0.05 0 0.1)
Vnsupply: voltage; -12
Vpsupply: voltage; 12
Named nets: 0, +V, -V, V_ModTriHalved, V_ModTri, V_InputTri, SpeakerOutput
.inc LM358.txt
.tran 0 9.2 9.1 startup uic
.inc BD135.txt
.inc BD136.txt
.inc CD4007.txt
.inc LM318.txt
