temurtas/EE313-Project/LTSpice/VCO_onlyORIGINAL.asc

C2: cap; 5n
M1: nmos; IRF510
R8: res; 5k
R9: res; 5k
R10: res; 5k
R11: res; 2.5k
R13: res; 10k
R14: res; 5k
U1: opamp2; LM318
U2: opamp2; LM318
V_InputTri1: voltage; PULSE(0.75 4.5 0 0.05 0.05 0 0.1)
Vnsupply1: voltage; -12
Vpsupply1: voltage; 12
Named nets: 0, +V, -V, V_ModTri, V_InputTri
.inc LM318.txt
.inc BD135.txt
.inc BD136.txt
.inc CD4007.txt
.tran 0 9.1 9 startup uic
