temurtas/EE313-Project/(commit log)

2017-12-27 poweramp değişti
2017-12-27 poweropamp fix
2017-12-28 finalımsı commit, filter calc eklendi
2018-01-02 Power Amplifier
    Power Amplifier section is re-typed with clear explanations. The simulation and practical results shall be added.
2018-01-19 VCO updated circuit
2018-01-20 Introduction, VCO and Power Amplfier
    Introduction, VCO and Power Amplfier are completed by experimental and theoretical results.
